TheHolsback/Drone-Mapeamento/sections/concepts.tex

\section{Fundamentação conceitual e trabalhos relacionados}
\label{sec:fundamentacao}

\subsection{Navegação relativa e complementaridade sensorial}

Na navegação relativa, a origem e a orientação inicial do referencial global são definidas no começo da coleta. A trajetória posterior é expressa em relação a essa condição inicial, sem equivaler a coordenadas geográficas ou a uma verdade absoluta de posição. Métodos de robótica móvel combinam fontes distintas porque nenhum sensor de baixo custo observa sozinho todos os estados com a mesma confiabilidade \parencite{thrun2005probabilistic,groves2013principles}.

As IMUs medem aceleração específica e velocidade angular no referencial do próprio sensor. Neste projeto, os giroscópios acompanham mudanças rápidas de orientação e os acelerômetros fornecem a direção da gravidade usada para corrigir a inclinação. A posição obtida por integração inercial livre não foi adotada como resultado principal, pois erros pequenos se acumulam rapidamente \parencite{tittertonWeston2004,farrell2008aided}. O filtro de Madgwick foi escolhido por estimar atitude com baixo custo computacional, combinando a resposta rápida do giroscópio com a referência gravitacional do acelerômetro \parencite{madgwick2010efficient}. A atitude é necessária sobretudo para orientar corretamente os pontos medidos pelo LiDAR.

O PMW3901 estima o deslocamento aparente entre observações sucessivas da superfície. O princípio se relaciona ao registro de imagens por fluxo óptico, embora o circuito realize internamente a análise e entregue apenas incrementos de movimento \parencite{lucasKanade1981,pixart2017pmw3901}. Sua função prática é fornecer odometria relativa no plano horizontal, evitando que esse deslocamento dependa apenas da dupla integração da aceleração. Como a conversão para escala métrica varia com a distância até a superfície, o VL53L1X fornece uma medida ToF usada como fator auxiliar de escala \parencite{stmicroelectronics2024vl53l1x}.

O LD06 mede ângulo, distância e intensidade do retorno em uma varredura de 360 graus \parencite{ldrobot2019ld06}. Diferentemente do sensor óptico, sua função não é estimar diretamente o deslocamento da plataforma, mas amostrar a geometria do ambiente. A integração ocorre quando cada ponto LiDAR recebe a posição e a atitude correspondentes ao instante de aquisição e, então, é transformado para o referencial global relativo.

Essa arquitetura não depende de uma única fonte de informação. Cada sensor observa apenas uma parcela do problema: o fluxo óptico contribui com deslocamento relativo, a IMU fornece atitude e continuidade temporal, o ToF atua como referência local de distância/proximidade e o LiDAR fornece pontos geométricos do ambiente. A fusão dessas informações permite estimar uma pose relativa suficiente para projetar as medições locais no referencial global do experimento, sem transformar o ToF ou o LiDAR em fontes isoladas de localização global.

\subsection{Atitude, referenciais e nuvem de pontos}

A atitude pode ser representada por ângulos de Euler ou quaternions. Os quaternions foram utilizados na propagação temporal devido à sua robustez matemática em relação aos ângulos de Euler: essa representação evita singularidades associadas ao fenômeno de \textit{gimbal lock} e permite composições sucessivas de rotações com melhor estabilidade numérica \parencite{diebel2006,siciliano2009robotics}. No contexto deste trabalho, essa característica é relevante porque a atitude estimada pela IMU é usada para transformar medições locais dos sensores para o referencial global relativo. Os ângulos de \textit{roll}, \textit{pitch} e \textit{yaw} foram mantidos na saída apenas por serem mais fáceis de inspecionar graficamente. O procedimento de filtragem da IMU e estimação de atitude por quaternions está documentado no notebook do Apêndice~\ref{ap:posicao}. Sem magnetômetro ou referência externa de rumo, o \textit{yaw} inicial é arbitrário e pode derivar, condição que afeta a orientação global da nuvem.

Uma nuvem de pontos global é formada ao acumular observações feitas em diferentes posições e atitudes. Para isso, é preciso conhecer tanto a transformação variável entre o corpo e o referencial global quanto a transformação fixa entre o LiDAR e o corpo. Erros de alinhamento, posição relativa ou sentido dos eixos aparecem como deformação ou dispersão da nuvem; a calibração extrínseca é, portanto, parte do desempenho do sistema, e não apenas um detalhe de montagem \parencite{siciliano2009robotics,rusu20113d}.

\subsection{Filtragem e critério de avaliação}

Os sinais inerciais de bancada contêm vibração e ruído acima da dinâmica de interesse. Um filtro passa-baixa Butterworth foi usado antes da estimação de atitude, enquanto médias entre as duas IMUs reduziram componentes não correlacionados. Nos dados LiDAR, critérios físicos removeram valores fora do domínio e limiares calculados a partir da própria distribuição rejeitaram retornos fracos e distâncias discrepantes. O limiar de intensidade foi obtido pelo método de Otsu \parencite{otsu1979threshold}, e descontinuidades de posição e atitude foram identificadas por cercas de Tukey \parencite{tukey1977eda}.

A avaliação geométrica adotada é deliberadamente parcial. As extensões robustas da nuvem no plano horizontal foram comparadas à largura e ao comprimento medidos do corredor. Esse procedimento avalia a escala e a coerência global do mapa, mas não substitui um sistema externo capaz de medir a trajetória verdadeira em cada instante.
