TheHolsback/Drone-Mapeamento/Circuito/main/report.txt

Foi plotado para 'C:\Users\gabri\Documents\Ceub\Drone-Mapeamento\Circuito\main\main.pdf'.

Foi plotado para 'C:\Users\gabri\Documents\Ceub\Drone-Mapeamento\Circuito\main\main.pdf'.

Informação: Feito.
Informação: Feito.
