TheHolsback/Drone-Mapeamento/main.tex

\documentclass[11pt,a4paper]{article}

\usepackage[T1]{fontenc}
\usepackage[utf8]{inputenc}
\usepackage[english,brazil]{babel}
\usepackage[a4paper,margin=2.5cm]{geometry}
\usepackage{lmodern}
\usepackage{microtype}
\usepackage{amsmath}
\usepackage{graphicx}
\usepackage{booktabs}
\usepackage{tabularx}
\usepackage{float}
\usepackage{xcolor}
\usepackage{csquotes}
\usepackage{caption}
\usepackage{pdfpages}
\usepackage{hyperref}

\graphicspath{{./}{./images/}}

\definecolor{linkblue}{RGB}{30,75,180}
\hypersetup{
    colorlinks=true,
    linkcolor=linkblue,
    urlcolor=linkblue,
    citecolor=linkblue,
    pdftitle={Projeto Experimental de Integração e Validação de Sensores para Navegação Relativa em Ambiente sem GPS},
    pdfauthor={Gabriel Holsback Dantas; Rafael de Queiroz Lavoyer}
}
\captionsetup{font=small,labelfont=bf}
\setlength{\parindent}{1.25cm}
\setlength{\parskip}{0pt}
\setcounter{topnumber}{3}
\setcounter{totalnumber}{5}
\renewcommand{\topfraction}{0.9}
\renewcommand{\textfraction}{0.05}
\renewcommand{\floatpagefraction}{0.8}

\usepackage[
    backend=biber,
    style=abnt,
    sorting=nyt,
    maxcitenames=3,
    mincitenames=1,
    maxbibnames=99
]{biblatex}
\addbibresource{main.bib}
\AtBeginBibliography{\small}

\title{\textbf{Projeto Experimental de Integração e Validação de Sensores para Navegação Relativa em Ambiente sem GPS}}
\author{Gabriel Holsback Dantas \quad Rafael de Queiroz Lavoyer\\[0.4em]
\small Curso de Engenharia da Computação, Centro Universitário de Brasília (CEUB)\\
\small \href{mailto:holsback@sempreceub.com}{holsback@sempreceub.com} \quad
\href{mailto:rafael.lavoyer@sempreceub.com}{rafael.lavoyer@sempreceub.com}}
\date{}

\begin{document}

\maketitle

\input{sections/abstract}
\input{sections/introduction}
\input{sections/concepts}
\input{sections/methodology}
\input{sections/conclusion}

\printbibliography[title={Referências}]

\appendix
\input{sections/appendices}

\end{document}
