TheHolsback/Drone-Mapeamento/sections/introduction.tex

\section{Introdução}
\label{sec:introducao}

A navegação de plataformas móveis em edifícios, galerias, cavernas e outras áreas confinadas não pode pressupor a disponibilidade contínua de GPS. Nesses ambientes, a posição e a atitude precisam ser inferidas a partir de medições locais, e o mapa construído passa a depender da consistência entre o movimento estimado e a geometria observada. Esse é um problema recorrente em robótica móvel e em veículos aéreos não tripulados empregados em inspeção e exploração \parencite{thrun2005probabilistic,beardMcLain2012}.

Uma unidade de medição inercial (IMU) é útil para acompanhar a atitude da plataforma, porém não resolve isoladamente o problema de posição. Pequenos vieses dos acelerômetros, ruído e erros na remoção da gravidade são acumulados durante a integração, produzindo deriva crescente, sobretudo quando se usam componentes de baixo custo \parencite{tittertonWeston2004,groves2013principles,farrell2008aided}. A proposta experimental deste trabalho evita, por isso, tratar a dupla integração da aceleração como referência principal de deslocamento.

Essa limitação pode ser observada mesmo em um caso numérico simples. Pela dupla integração da aceleração, um viés constante de apenas $0{,}01\,\mathrm{m/s^2}$, mantido por $30\,\mathrm{s}$, produz um erro de posição de aproximadamente $4{,}5\,\mathrm{m}$, valor obtido por $s = \frac{1}{2}at^2$. Em um percurso experimental da ordem de $7\,\mathrm{m}$, esse erro já seria comparável à própria dimensão avaliada. Por esse motivo, a IMU foi empregada principalmente para estimativa de atitude e apoio em intervalos curtos, enquanto o fluxo óptico foi adotado como referência primária de deslocamento horizontal.

O sistema combina sensores com funções complementares. O fluxo óptico fornece incrementos de movimento no plano observado e reduz a dependência da integração inercial; um sensor ToF auxilia a correção de escala em função da distância ao piso; as IMUs estimam a atitude e apoiam a propagação em intervalos curtos sem atualização óptica; e o LiDAR mede a geometria ao redor da plataforma. Com a posição e a atitude relativas estimadas, cada retorno do LiDAR pode ser levado do referencial do sensor a um referencial global definido no início do ensaio.

O objetivo deste artigo é avaliar experimentalmente se essa integração permite manter uma referência espacial relativa e produzir uma nuvem de pontos global em ambiente sem GPS. A avaliação foi conduzida em um corredor, com sensores de baixo custo instalados em uma plataforma móvel terrestre. Essa plataforma foi adotada para validar aquisição, montagem e processamento com menor risco antes de uma futura migração para voo; portanto, os resultados caracterizam a prova de conceito do pipeline sensorial, e não o desempenho aerodinâmico ou de controle de um drone.

A contribuição principal é a implementação e a análise crítica da cadeia completa de aquisição, pré-processamento, estimação de atitude e deslocamento relativo, associação temporal e transformação dos pontos LiDAR. A coerência geométrica foi avaliada de forma preliminar pelas dimensões horizontais conhecidas do corredor. Não se reivindica localização absoluta: não houve referência externa ponto a ponto para a trajetória, e a dimensão vertical não pôde ser validada por ausência de medida confiável do teto.
