TheHolsback/Drone-Mapeamento/sections/abstract.tex

\begin{abstract}
Ambientes confinados limitam o uso de sistemas globais de navegação por satélite, enquanto a posição estimada apenas por sensores inerciais de baixo custo é suscetível à deriva. Este artigo apresenta uma prova de conceito para navegação relativa e mapeamento baseada em sensor óptico PMW3901, ToF VL53L1X, duas unidades de medição inercial e LiDAR LD06. O conjunto foi montado em uma plataforma terrestre, como etapa de integração destinada a um drone, e deslocado em um corredor sem GPS. O fluxo óptico forneceu deslocamento horizontal, as IMUs forneceram atitude e apoio nos intervalos sem atualização óptica, e os pontos LiDAR foram transformados para um referencial global relativo. O ensaio de 52,07~s produziu 1.041 pontos filtrados. Em comparação com a largura de 1,20~m e o comprimento de 7,00~m do corredor, medidos três vezes, as amplitudes robustas apresentaram erros de 62,61\% e 2,63\%. O resultado demonstra a viabilidade funcional do pipeline, mas o erro transversal evidencia a influência da montagem e da calibração extrínseca. Sem medida confiável do teto, não houve validação vertical. A prova de conceito manteve uma referência espacial relativa e gerou a nuvem global, mas não validou localização absoluta.

\noindent\textbf{Palavras-chave:} navegação relativa; ambiente sem GPS; fluxo óptico; unidade de medição inercial; LiDAR; nuvem de pontos.
\end{abstract}

\selectlanguage{english}
\begin{abstract}
Confined environments restrict global navigation satellite systems, while position estimates based only on low-cost inertial sensors are susceptible to drift. This article presents a proof of concept for relative navigation and mapping based on a PMW3901 optical sensor, a VL53L1X time-of-flight sensor, two inertial measurement units, and an LD06 LiDAR. The assembly was installed on a ground platform, as an integration stage intended for a drone, and moved along a corridor without GPS. Optical flow supplied horizontal displacement, the IMUs provided attitude and short-term support during optical-update gaps, and LiDAR points were transformed into a relative global frame. The 52.07~s trial produced 1,041 filtered points. Against the corridor width of 1.20~m and length of 7.00~m, each measured three times, the robust spans showed errors of 62.61\% and 2.63\%. The result demonstrates pipeline feasibility, but the transverse error exposes sensitivity to mounting and extrinsic calibration. No reliable ceiling measurement was available for vertical validation. The proof of concept maintained a relative spatial reference and generated a global point cloud, but did not validate absolute localization.

\noindent\textbf{Keywords:} relative navigation; GPS-denied environment; optical flow; inertial measurement unit; LiDAR; point cloud.
\end{abstract}
\selectlanguage{brazil}
