TheHolsback/Drone-Mapeamento/sections/cover.tex

\begin{titlepage}
\\
\vspace{2cm}
    \begin{center}
        \vspace*{1cm}
        
        {\LARGE \textbf{Mapeamento 3D de Ambientes sem GPS com Drone: Integração de Fluxo Óptico, IMU e LiDAR}}
        
        \vspace{0.5cm}
        TRABALHO DE CONCLUSÃO DE CURSO
        
        \vspace{1.5cm}
        por \\
        \vspace{1.5cm}
            Gabriel Holsback Dantas - \url{holsback@sempreceub.com} - RA: 22310899\\
            Rafael De Queiroz Lavoyer - \url{rafael.lavoyer@sempreceub.com} - RA: 22208760\\
        \vspace{1.0cm}
    \end{center}

    \vspace{1cm}
\noindent{
{
    {\bf Resumo:}
    Este trabalho apresenta uma metodologia de aquisição e processamento para localização relativa e geração de nuvem de pontos em ambientes sem sinal de GPS. A abordagem combina sensor óptico de fluxo, sensor de distância ToF, duas unidades de medição inercial e LiDAR 2D. O fluxo óptico fornece a odometria primária no plano horizontal, a IMU estima atitude e preenche intervalos sem medição óptica, e o LiDAR é transformado do referencial local do drone para o referencial global para reconstrução tridimensional do ambiente.
    }
}
\vfill
\textcolor[rgb]{0.5,0.5,0.5}{
    \begin{flushleft}
    { \small
    Orientador: Hudson Capanema Zaidan\\
    Turma: UN2026/07\\
    Curso: Engenharia da Computação\\
    Campus: Asa Norte\\
    Turno: Noturno
    }
    \end{flushleft}
}
      
\end{titlepage}
