TheHolsback/Drone-Mapeamento/sections/abbreviation.tex

\chapter*{Abreviaturas}
\addcontentsline{toc}{chapter}{Abreviaturas}

\begin{tabularx}{\textwidth}{>{\raggedright\arraybackslash}p{2.6cm} >{\raggedright\arraybackslash}X}
GPS   & Sistema de Posicionamento Global (\textit{Global Positioning System})\\
IMU   & Unidade de Medição Inercial (\textit{Inertial Measurement Unit})\\
LiDAR & Detecção e medição por luz (\textit{Light Detection and Ranging})\\
ToF   & Tempo de voo (\textit{Time of Flight})\\
MEMS  & Sistemas microeletromecânicos (\textit{Micro-Electro-Mechanical Systems})\\
RPY   & \textit{Roll}, \textit{pitch} e \textit{yaw}\\
DoF   & Graus de liberdade (\textit{Degrees of Freedom})\\
CSV   & Valores separados por vírgula (\textit{Comma-Separated Values})\\
SD    & Cartão de memória digital (\textit{Secure Digital})\\
UART  & Receptor/transmissor assíncrono universal (\textit{Universal Asynchronous Receiver/Transmitter})\\
I2C   & Barramento serial inter-integrado (\textit{Inter-Integrated Circuit})\\
SPI   & Interface serial periférica (\textit{Serial Peripheral Interface})\\
PWM   & Modulação por largura de pulso (\textit{Pulse Width Modulation})\\
MCU   & Microcontrolador (\textit{Microcontroller Unit})\\
ZYX   & Sequência de rotações usada na composição $R_z(\psi)R_y(\theta)R_x(\phi)$\\
W     & Referencial do mundo ou global (\textit{World Frame})\\
B     & Referencial do corpo do drone (\textit{Body Frame})\\
L     & Referencial local do LiDAR (\textit{LiDAR Frame})\\
\end{tabularx}
