TheHolsback/Drone-Mapeamento/images/uniceub_logo-eps-converted-to.pdf

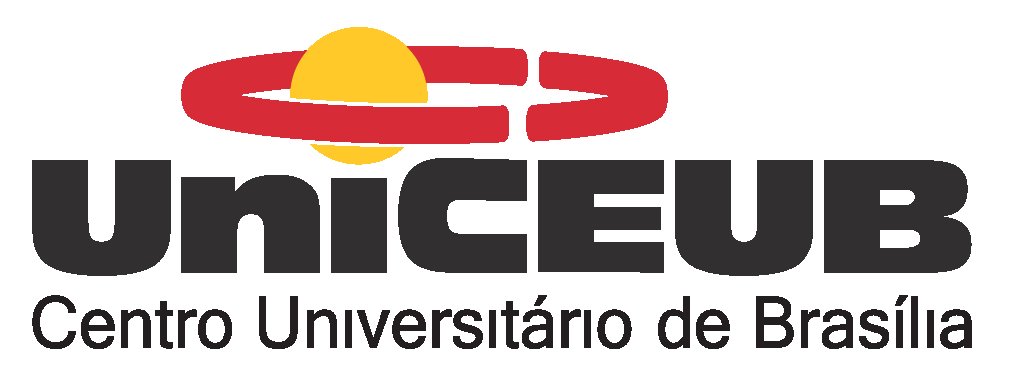
[picture p27: page 1]
