TheHolsback/Drone-Mapeamento/Circuito/PCB/TCCPCB.png

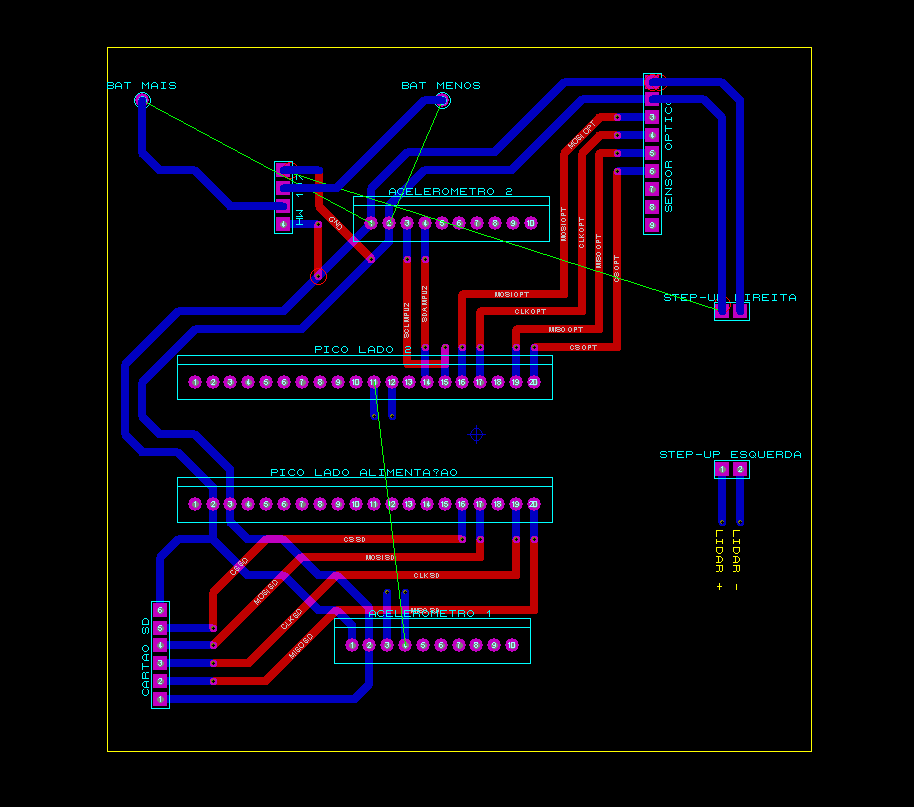
Circuito/PCB/TCCPCB.png
