TheHolsback/Drone-Mapeamento/imu_summary.png

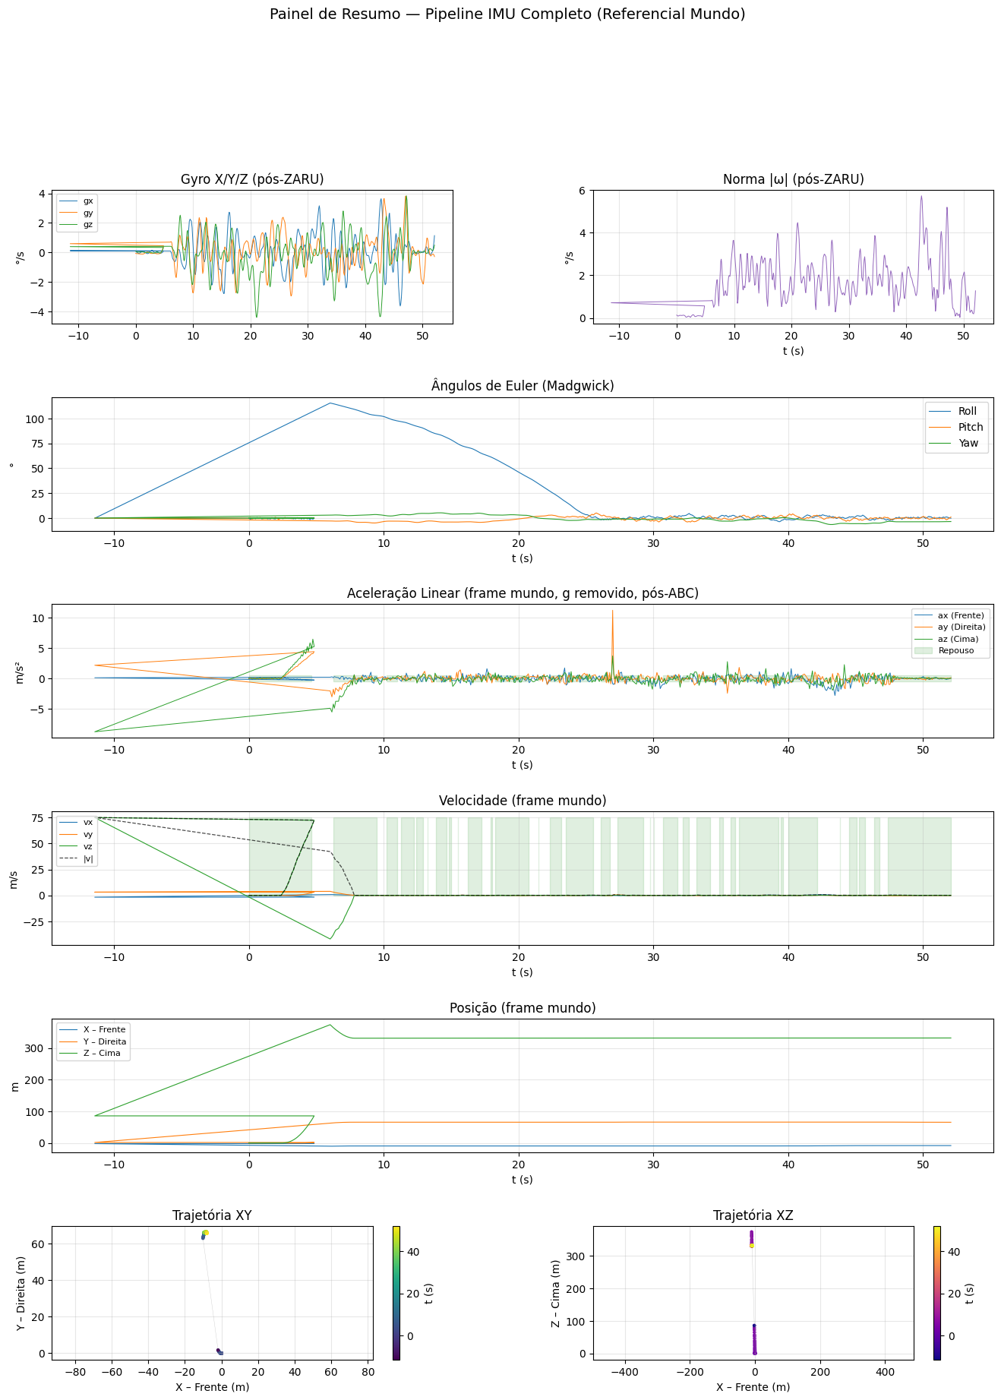
imu_summary.png
