TheHolsback/Drone-Mapeamento/imu_summary_fused.png

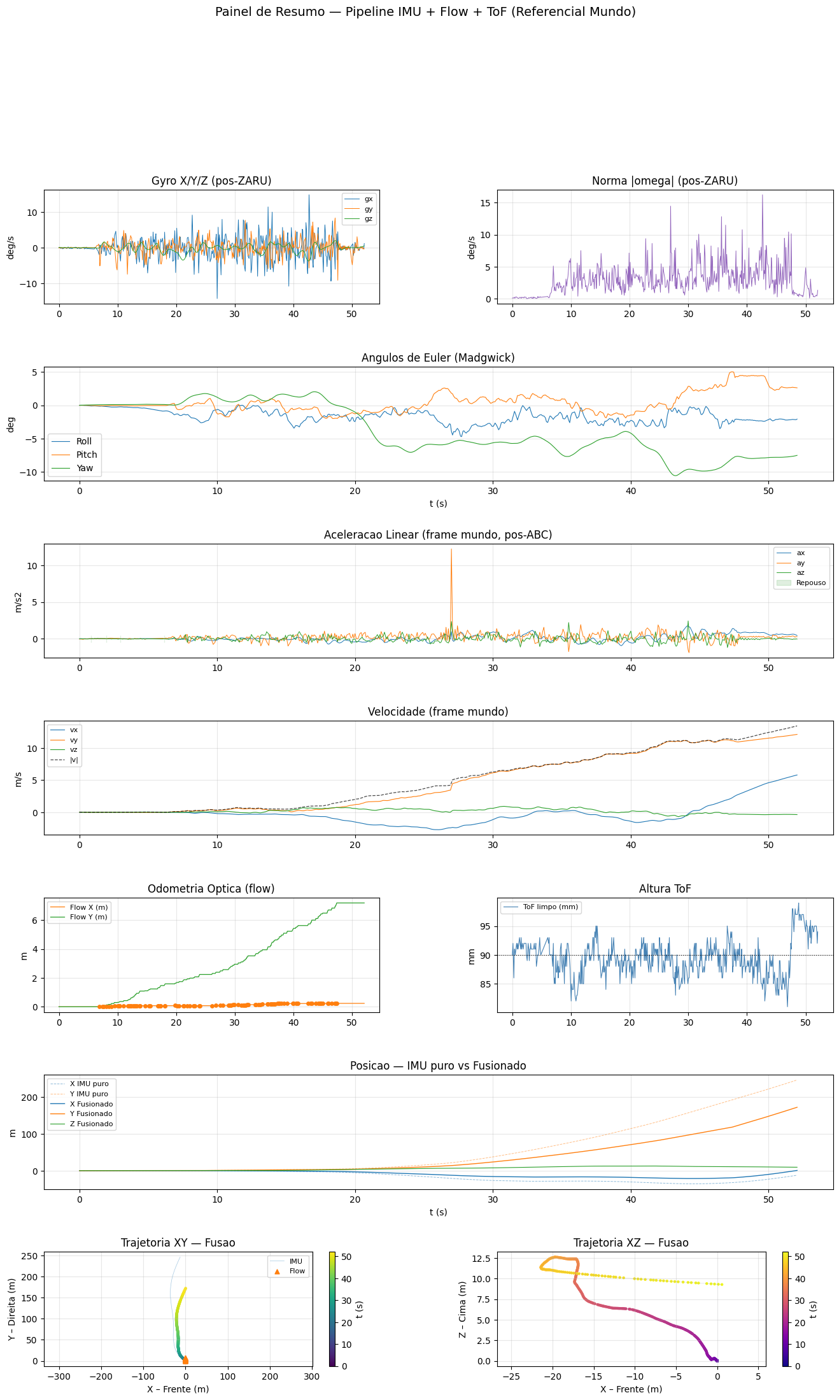
imu_summary_fused.png
