TheHolsback/Drone-Mapeamento/Sensor_optico.SLDPRT

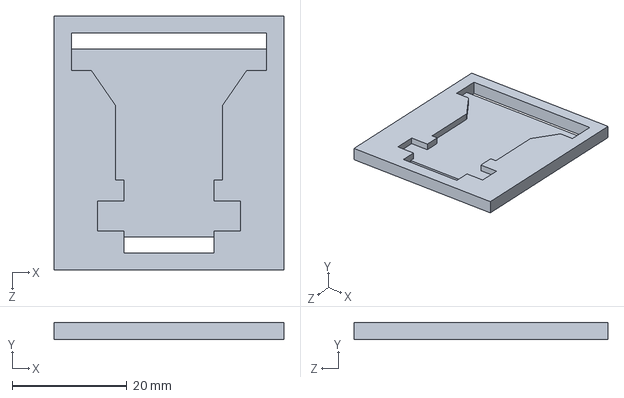
[picture p31: CAD file, 2026-06-09]
Sensor_optico.SLDPRT
40.0 x 3.00 x 44.2 mm
