TheHolsback/Drone-Mapeamento/Placa suporte.SLDPRT

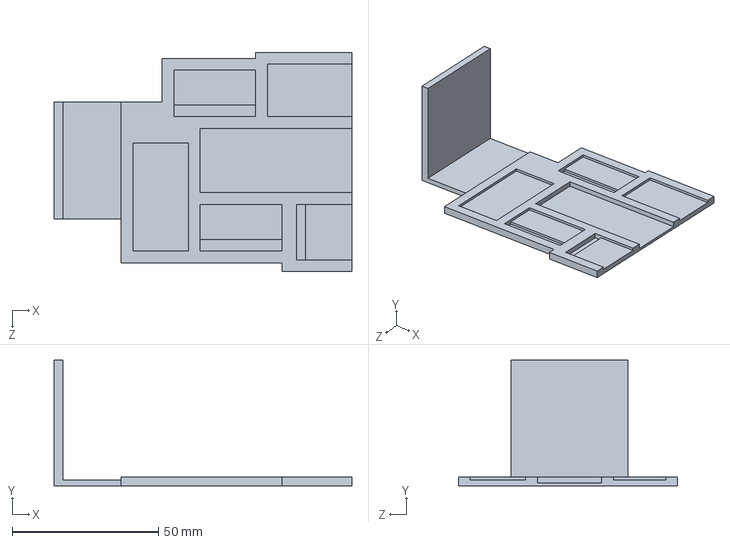
[picture p32: CAD file, 2026-04-27]
Placa suporte.SLDPRT
102.0 x 43.0 x 75.0 mm
