TheHolsback/Drone-Mapeamento/(list of files, cad)

Other CAD files:
Placa suporte.STL
Sensor_optico.STL
