TheHolsback/Drone-Mapeamento/Circuito/main/main.pdf

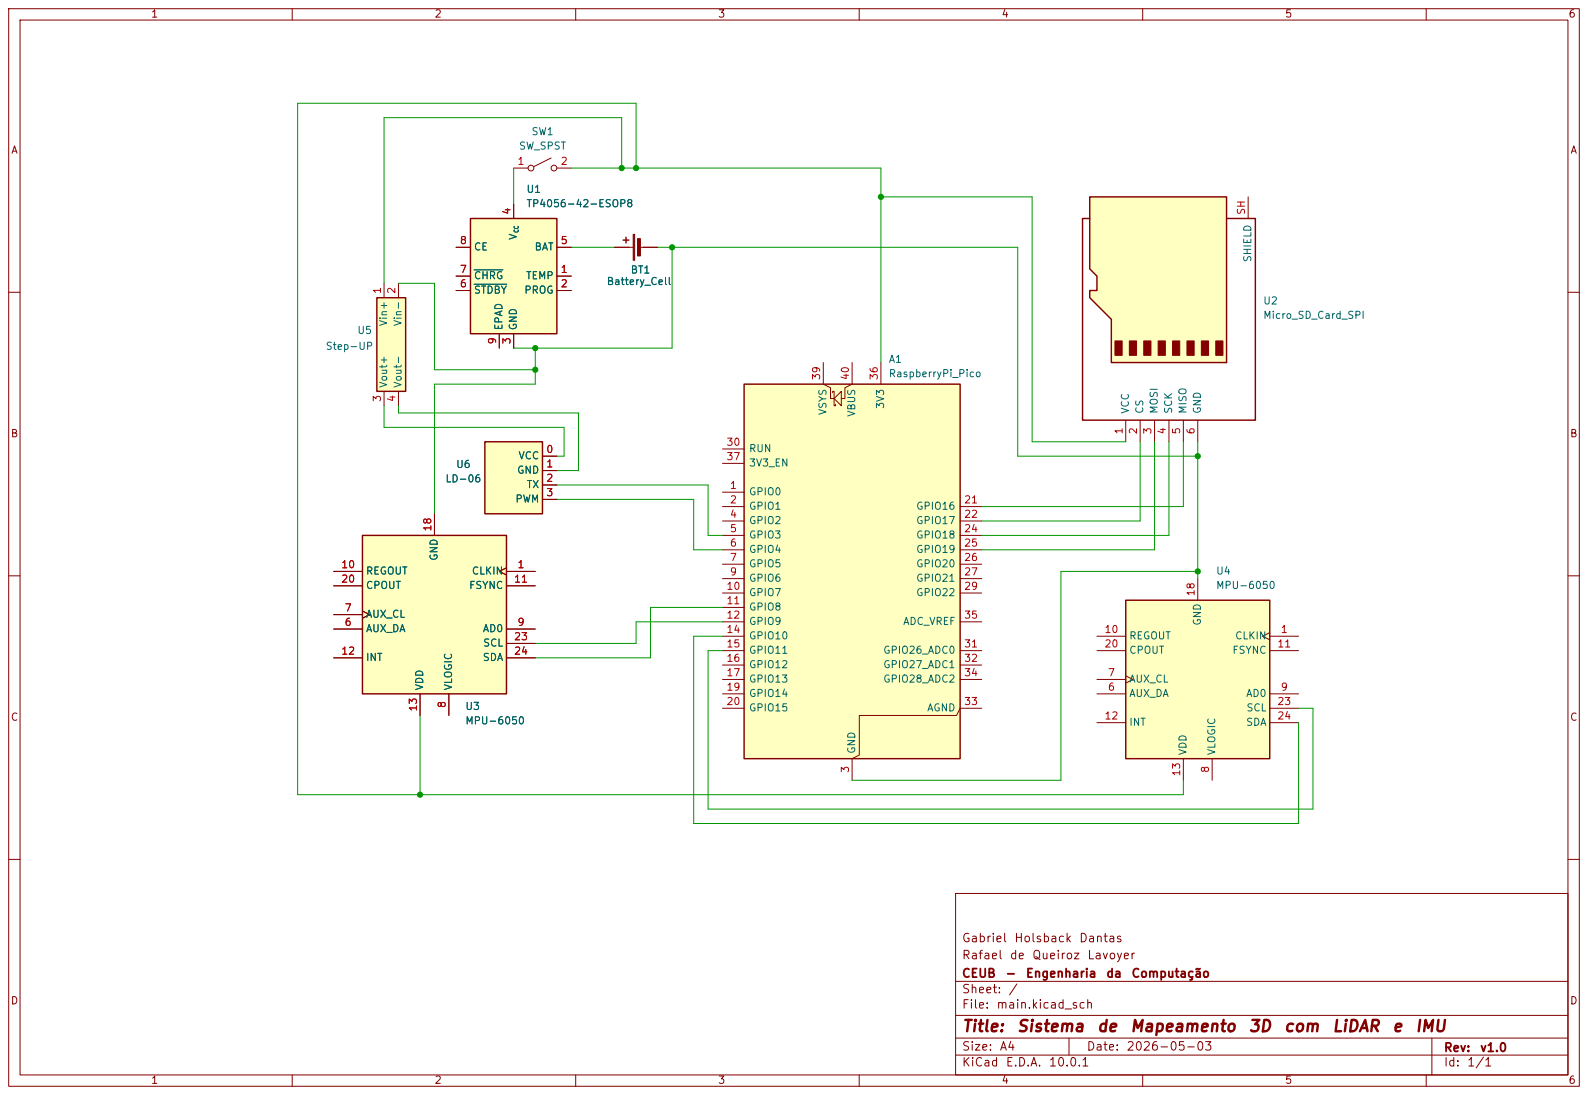
[picture p33: page 1]

Rafael de Queiroz Lavoyer
CEUB - Engenharia da Computação
Sheet: /
File: main.kicad_sch
Title: Sistema de Mapeamento 3D com LiDAR e IMU

Size: A4 | Rev: v1.0
KiCad E.D.A. 10.0.1 | Id: 1/1
