TheHolsback/Drone-Mapeamento/Circuito/main_a4.pdf

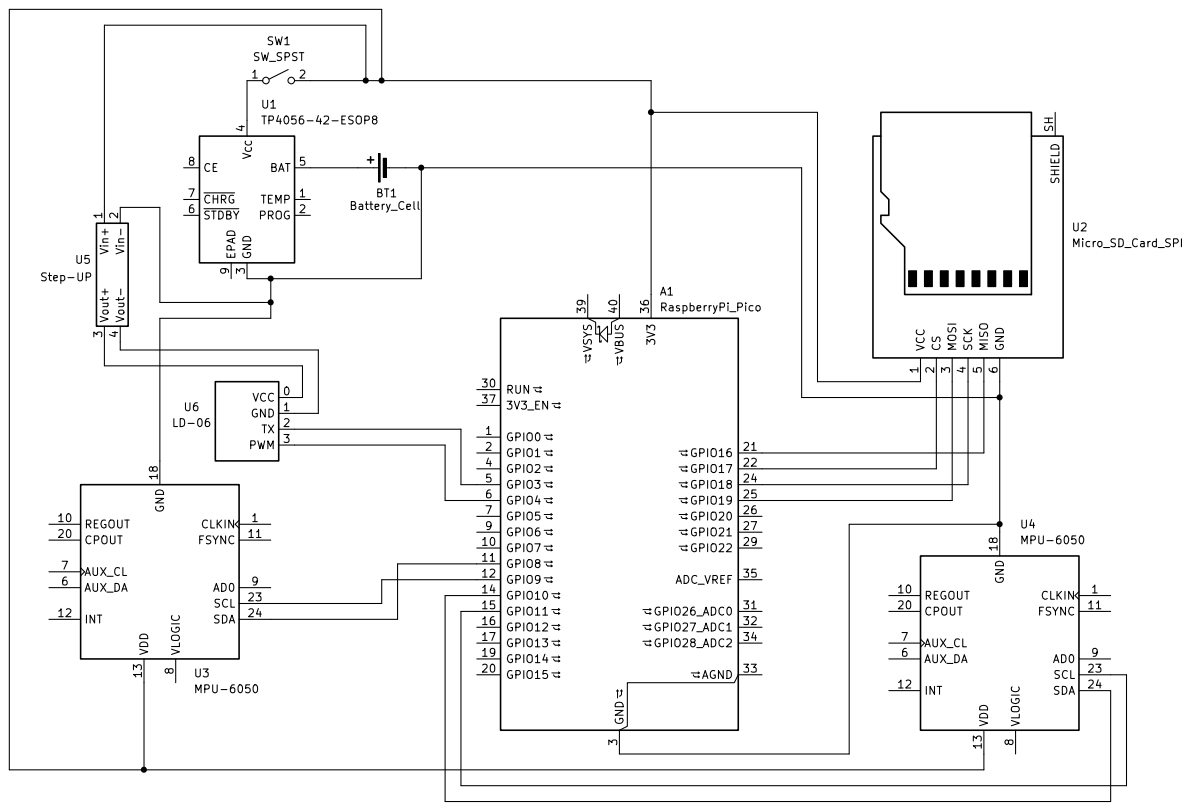
[picture p34: page 1]
