TheHolsback/Drone-Mapeamento/(list of files, drawings)

Other design files:
Circuito/PCB/ProjetoPCBTCC1 (1).LYT
Circuito/PCB/ProjetoPCBTCC1.DSN
Circuito/PCB/ProjetoPCBTCC1.LYT
