TheHolsback/Drone-Mapeamento/Circuito/main/main.kicad_sch

## KiCad design Circuito/main/main.kicad_sch (2026-06-09)

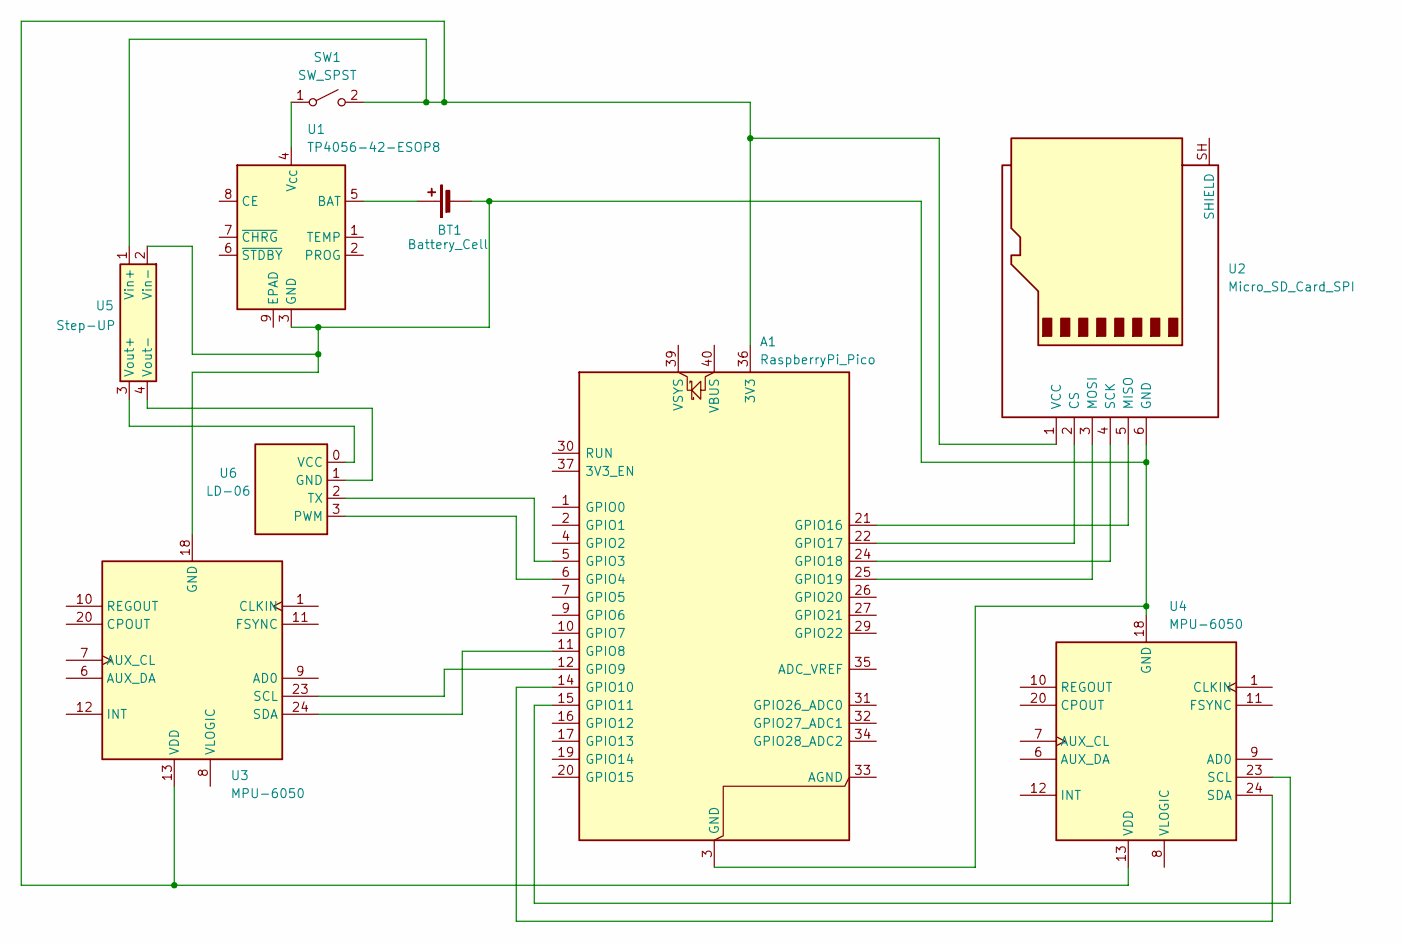
[picture p35: schematic main.kicad_sch]

Parts:
A1: RaspberryPi_Pico; RaspberryPi_Pico_Common_Unspecified
BT1: Battery_Cell
SW1: SW_SPST
U1: TP4056-42-ESOP8; SOIC-8-1EP_3.9x4.9mm_P1.27mm_EP2.41x3.3mm_ThermalVias
U2: Micro_SD_Card_SPI
U3, U4: MPU-6050; InvenSense_QFN-24_4x4mm_P0.5mm
U5: Step-UP
U6: LD-06

Connections:
unnamed: A1.5 (GPIO3), U6.2 (TX)
unnamed: A1.6 (GPIO4), U6.3 (PWM)
unnamed: A1.11 (GPIO8), U3.24 (SDA)
unnamed: A1.12 (GPIO9), U3.23 (SCL)
unnamed: A1.3 (GND), A1.8 (GND), A1.13 (GND), A1.18 (GND), A1.23 (GND), A1.28 (GND), A1.38 (GND), BT1.2 (-), U1.3 (GND), U2.6 (GND), U3.18 (GND), U4.18 (GND), U5.2 (Vin-)
unnamed: A1.14 (GPIO10), U4.24 (SDA)
unnamed: A1.15 (GPIO11), U4.23 (SCL)
unnamed: A1.21 (GPIO16), U2.5 (MISO)
unnamed: A1.22 (GPIO17), U2.2 (CS)
unnamed: A1.24 (GPIO18), U2.4 (SCK)
unnamed: A1.25 (GPIO19), U2.3 (MOSI)
unnamed: A1.36 (3V3), SW1.2 (B), U2.1 (VCC), U3.13 (VDD), U4.13 (VDD), U5.1 (Vin+)
unnamed: BT1.1 (+), U1.5 (BAT)
unnamed: SW1.1 (A), U1.4 (V_{CC})
unnamed: U5.3 (Vout+), U6.0 (VCC)
unnamed: U5.4 (Vout-), U6.1 (GND)
