TheHolsback/Drone-Mapeamento/(commit log)

2026-04-27 feat: código do arduino, python para decidir a intensidade mínima e dados inciais
    [DADOS.CSV, LIDAR.CSV, Placa suporte.SLDPRT, Placa suporte.STL]
2026-05-04 Refactor methodology and data processing sections in LaTeX documents
    - Updated methodology section to include detailed steps for sensor integration and data collection.
    - Enhanced data collection section with specific sensor configurations and expected reference values.
    - Improved data validation and processing subsections with clearer descriptions and mathematical formulations.
    - Corrected formatting issues and added necessary LaTeX packages for better document structure.
    - Revised conclusion section to ensure consistency in terminology and formatting.
2026-06-09 feat: dados de posição
    [DADOS.CSV, LIDAR.CSV, Sensor_optico.SLDPRT, Sensor_optico.STL, dados_1.csv, dados_2.csv, main.kicad_pcb, main.kicad_sch]
2026-06-09 fix: seç~eos
    [nuvem_pontos_lidar_global.csv, posicoes_lidar_imu.csv]
2026-06-19 fix: mudança para artigo
2026-06-19 fix: pose para posição e atittude
2026-06-21 feat: imagens PCB, ajustes no anexo
    [ProjetoPCBTCC1 (1).LYT, ProjetoPCBTCC1.DSN, ProjetoPCBTCC1.LYT]
2026-06-24 feat: novos paragrafos em conculsao e imu pipeline
